nesl/USBAudioAmp/USBAudioAmpBOM.xls

Comment | Description | Designator | Value | Footprint | LibRef | Quantity | Distributor | Distributor Part Number | Unit Price | Extended Price
CAP_POL | CAP | C20 | 1000uF | CAP-CAN-SMD-POL-12.5mmDia | CAP_POL | 1 | Digikey | PCE3462CT-ND | 1.61 | 1.61
CAP_POL | CAP | C18, C19, C23, C24 | 10uF | SM/C_POL_0805 | CAP_POL | 4 | Digikey | 587-1295-1-ND | 0.25 | 1
CAP | CAP | C3, C4, C6, C8 | 0.01uF | SM/C_0805 | CAP | 4 | Digikey | 445-2672-1-ND | 0.36 | 1.44
CAP | CAP | C22, C26, C36,C37 | 4.7uF | SM/C_0805 | CAP | 3 | Digikey | 587-1294-1-ND | 0.24 | 0.72
CAP | CAP | C32, C35 | 10uF | SM/C_0805 | CAP | 2 | Digikey | 587-1295-1-ND | 0.25 | 0.5
CAP | CAP | C33, C34 | 22pF | SM/C_0805 | CAP | 2 | Digikey | 478-1280-1-ND | 0.15 | 0.3
CAP_POL | CAP | C14, C17 | 100uF | SM/CT_6032_12 | CAP_POL | 2 | Digikey | 399-5214-1-ND | 1.34 | 2.68
CAP | CAP | C15, C16 | 470nF | SM/C_0805 | CAP | 2 | Digikey | 587-1282-1-ND | 0.12 | 0.24
CAP | CAP | C1, C2, C5, C7, C9, C10, C11, C12, C13, C21, C25, C27, C28, C29, C30, C31, C38, C39 | 1uF | SM/C_0805 | CAP | 18 | Digikey | 445-1590-1-ND | 0.1 | 1.8
Res | Resistor | R38 | 715 | SM/R_0805 | Res | 1 | Digikey | P715CCT-ND | 0.1 | 0.1
Res | Resistor | R7, R13, R15, R18 | 499K | SM/R_0805 | Res | 4 | Digikey | P499KCCT-ND | 0.1 | 0.4
Res | Resistor | R37, R45 | 470 | SM/R_0805 | Res | 2 | Digikey | P470CCT-ND | 0.1 | 0.2
Res | Resistor | R34 | 392 | SM/R_0805 | Res | 1 | Digikey | P392CCT-ND | 0.1 | 0.1
Res | Resistor | R36 | 330 | SM/R_0805 | Res | 1 | Digikey | P330CCT-ND | 0.1 | 0.1
Res | Resistor | R35, R39 | 240 | SM/R_0805 | Res | 2 | Digikey | P240CCT-ND | 0.1 | 0.2
Res | Resistor | R8, R20 | 191k | SM/R_0805 | Res | 2 | Digikey | P191KCCT-ND | 0.1 | 0.2
Res | Resistor | R6, R19 | 40.2k | SM/R_0805 | Res | 2 | Digikey | P40.2KCCT-ND | 0.1 | 0.2
Res | Resistor | R41, R42 | 22 | SM/R_0805 | Res | 2 | Digikey | P22.0CCT-ND | 0.1 | 0.2
Res | Resistor | R1, R2, R3, R4, R11, R12, R14, R22, R23, R24 | 10K | SM/R_0805 | Res | 10 | Digikey | P10.0KCCT-ND | 0.1 | 1
Res | Resistor | R31 | 3K3 | SM/R_0805 | Res | 1 | Digikey | P3.30KCCT-ND | 0.1 | 0.1
Res | Resistor | R25, R26, R28, R30 | 3K | SM/R_0805 | Res | 4 | Digikey | P3.0KCCT-ND | 0.1 | 0.4
Res | Resistor | R9, R21, R47, R48, R49 | 1M | SM/R_0805 | Res | 5 | Digikey | P1.00MCCT-ND | 0.1 | 0.5
Res | Resistor | R27, R29, R40, R43, R44, R46 | 1k5 | SM/R_0805 | Res | 6 | Digikey | P1.50KCCT-ND | 0.1 | 0.6
Res | Resistor | R32, R33 | 1K | SM/R_0805 | Res | 2 | Digikey | P1.00KCCT-ND | 0.1 | 0.2
Inductor |  | L1 | 10uH | SM/L_0805 | Inductor | 1 | Digikey | 445-6762-1-ND | 0.14 | 0.14
0031.8221 | FUSEHOLDER BLACK FOR SMD 5X20MM | F1 |  | SCHURTER/SMD/2 PADS/0031.8221 | 2105 | 1 | Digikey | 486-1260-ND | 1.01 | 1.01
0031.8221, Ferrite Bead | Ferrite Bead | F2, F3 |  | SM/R_0805 | Ferrite Bead | 2 | Digikey | 445-2190-1-ND | 0.11 | 0.22
22uH | INDUCTOR SHIELD PWR 22UH 10145 | L2, L3 |  | G_JMETRIC/TDK/SLE10145 | 1660 | 2 | Digikey | 445-1981-1-ND | 1.17 | 2.34
4 POS DIP SWITCH |  | SW1 |  | DIPSW4PIN | 4 POS DIP SWITCH | 1 | Digikey | 450-1364-ND | 0.8 | 0.8
ADG1609 |  | U1, U4 |  | TSSOP 16LEAD - Analog Devices - ADG1609 | ADG1609 | 2 | Digikey | ADG1609BRUZ-ND | 8.53 | 17.06
ADJ_VOLT_REG |  | VR1, VR2 |  | LM317-SOT233-POS-ADJ-VOLT_REG | ADJ_VOLT_REG | 2 | Digikey | LM317EMPCT-ND | 1.23 | 2.46
CDBA120SL-G, SMAJ20CA-TP | TVS 400W 12V BIDIRECT SMA | D6, TVS1 |  | D0-214AC | 2519, Schottky Diode_AC | 2 | Digikey | SMAJ20CA-TPMSCT-ND | 0.55 | 1.1
INA331 |  | U2, U3 |  | MSOP-8PIN-TI | INA331 | 2 | Digikey | 296-12203-1-ND | 3.03 | 6.06
JMPR | Jumper | J1 |  | M03x1-nolock | JMPR-3 | 1 | Digikey | A31113-ND | 0.22 | 0.22
LED |  | D1, D2, D3, D4, D5 |  | LED-0805 | LED | 5 | Digikey | 160-1423-1-ND | 0.32 | 1.6
M03x1 |  | CON1, CON2, CON3 |  | M03x1 | M03x1 | 3 | Digikey | A19901-ND | 0.27 | 0.81
OPA335 |  | U5, U6, U7 |  | SOT23-5 -TI | OPA335 | 3 | Digikey | 296-26271-1-ND | 3.03 | 9.09
PCM2906 |  | U9 |  | SSOP-28PIN-TI | PCM2906C | 1 | Digikey | 296-24138-1-ND | 12.07 | 12.07
Res | Resistor | JC1, JC2, JO1, JO2, R5, R10, R16, R17 | 0 | SM/R_0805 | Res | 8 | Digikey | P0.0ACT-ND | 0.05 | 0.4
SI4423DY-T1-E3 | mosfet,p ch,20v,10a,8soic; transistor polarity:p channel; | Q1 |  | SOIC-8-Lead-Vishay-PFET | 2390 | 1 | Digikey | SI4423DY-T1-E3CT-ND | 2.35 | 2.35
SPDTSwitch |  | S1 |  | SPDTSwitch | SPDTSwitch | 1 | Digikey | 401-1999-1-ND | 0.65 | 0.65
STA540 |  | U8 |  | STA540_Multiwatt15 | STA540 | 1 | Digikey | 497-8880-5-ND | 5.88 | 5.88
TERM BLOCK 2POS |  | INL, INR, OUTL, OUTR, VPWR |  | Conn-ScrewTerminal-2pin-Phoenix | 2Pin-PhoenixTerminalBlock | 5 | Digikey | 277-1964-ND | 1.72 | 8.6
TEST_PT |  | TP_GND1, TP_GND2, TP_STDBY, TP_VCCI, TP_VDD, TP_VIN1, TP_VIN2, TP_VOUTL, TP_VOUTR, TP_VREF |  | TEST_PT_SMD | TEST_PT | 10 | Digikey | 952-1478-1-ND | 0.399 | 3.99
USB MiniB | Mini USB | USB |  | USB-MINIB | USB MiniB | 1 | Digikey | H2961CT-ND | 1.25 | 1.25
XTAL-FA238V |  | X1 |  | XTAL 12MHz SMD | XTAL-FA238V | 1 | Digikey | SER3682CT-ND | 2.25 | 2.25
 |  |  |  |  | Part Count | 139 |  |  | Total Sum | 95.14
