nesl/USBAudioAmp/(list of files, drawings)

Other design files:
AmplifierInput.SchDoc
AmplifierOutput.SchDoc
PWRSUPPLY.SchDoc
USBAudioAmp.PcbDoc
USBAudioAmp.PrjPCB
USBStereoAudioCodec.SchDoc
