nesl/USBAudioAmp/(commit log)

2012-08-17 Typo in Readme
    [AmplifierInput.SchDoc, AmplifierOutput.SchDoc, PWRSUPPLY.SchDoc, USBAudioAmp.PrjPCB, USBStereoAudioCodec.SchDoc]
2012-09-16 Went to four layer board to reduce noise. Flipped USB Audio Codec chip to shorten USB line, again to reduce noise.
    [AmplifierInput.SchDoc, AmplifierOutput.SchDoc, BoardShape.dwg, PWRSUPPLY.SchDoc, USBAudioAmp.PcbDoc, USBAudioAmp.PrjPCB, USBAudioAmpBOM.xls, USBStereoAudioCodec.SchDoc]
2013-06-18 Fixed Missed enable on instrumentation amps
    [USBAudioAmp.PcbDoc, USBAudioAmp.PrjPCB, USBAudioAmpBOM.xls]
